mlab-modules/HEATBEDMAG01/hw/cad/step/heater-PCB.stp

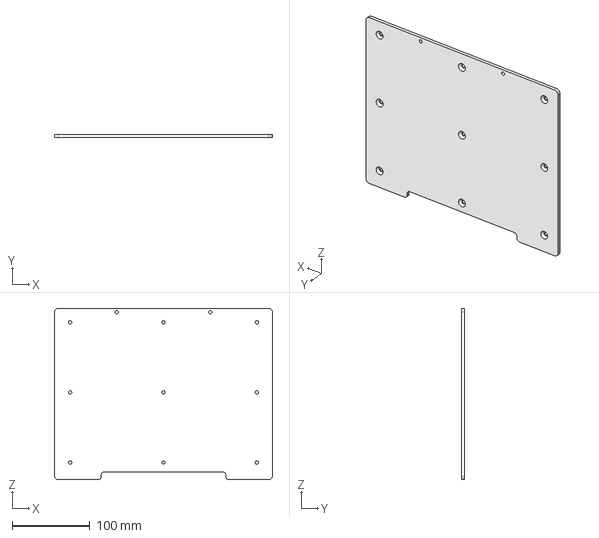
[picture p1: CAD file, 2020-06-01]
hw/cad/step/heater-PCB.stp
280.0 x 4.00 x 220.0 mm
