mlab-modules/HEATBEDMAG01/hw/dxf/slots-for-magnets.dxf

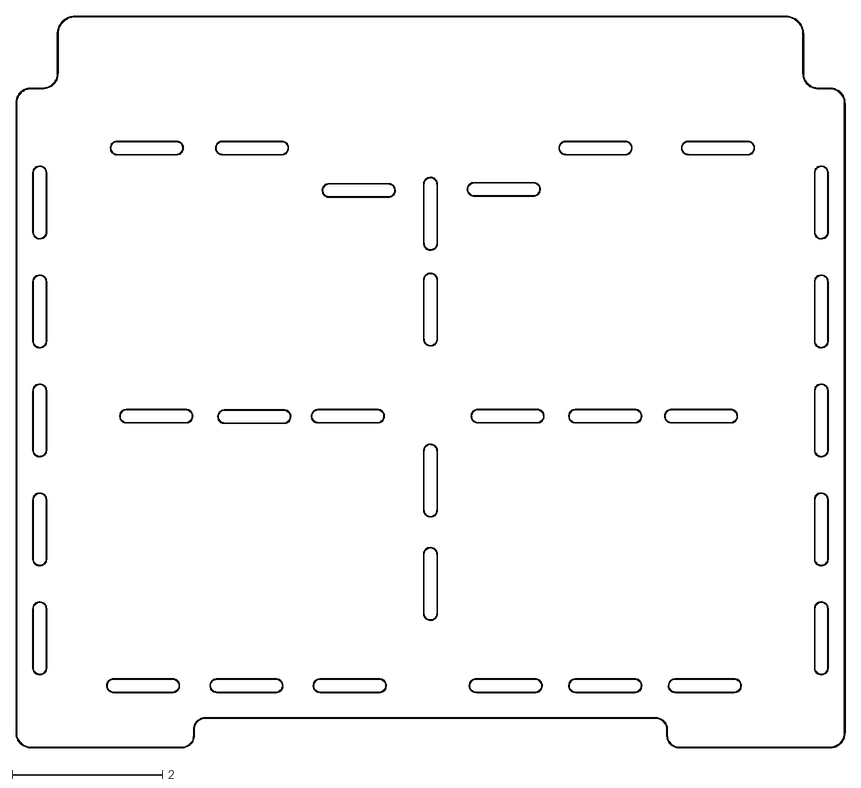
[picture p2: CAD file, 2020-09-24]
hw/dxf/slots-for-magnets.dxf
11.0 x 9.74
