mlab-modules/HEATBEDMAG01/hw/dxf/steel-sheet.dxf

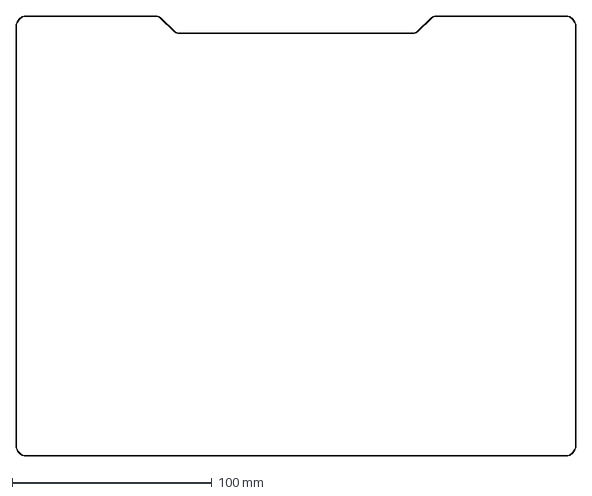
[picture p3: CAD file, 2020-09-18]
hw/dxf/steel-sheet.dxf
280.0 x 220.0 mm
