mlab-modules/HEATBEDMAG01/hw/dxf/heatbed_table.dxf

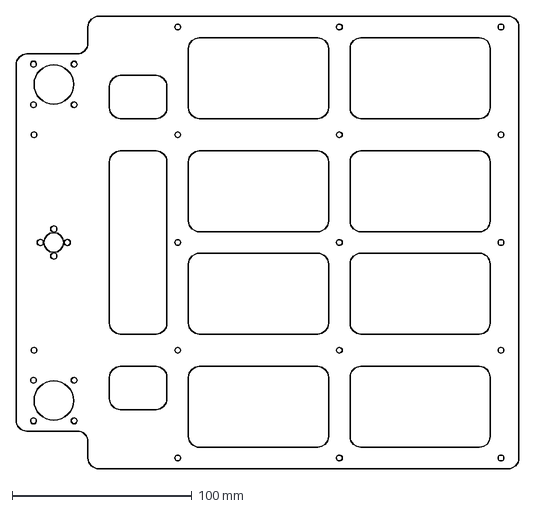
[picture p4: CAD file, 2020-09-13]
hw/dxf/heatbed_table.dxf
280.0 x 252.0 mm
