mlab-modules/HEATBEDMAG01/hw/dxf/Heatbed.dxf

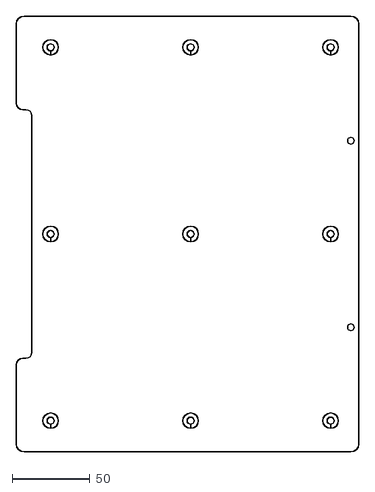
[picture p5: CAD file, 2020-06-01]
hw/dxf/Heatbed.dxf
220.0 x 280.0
