mlab-modules/HEATBEDMAG01/hw/sch_pcb/Heatbed.pdf

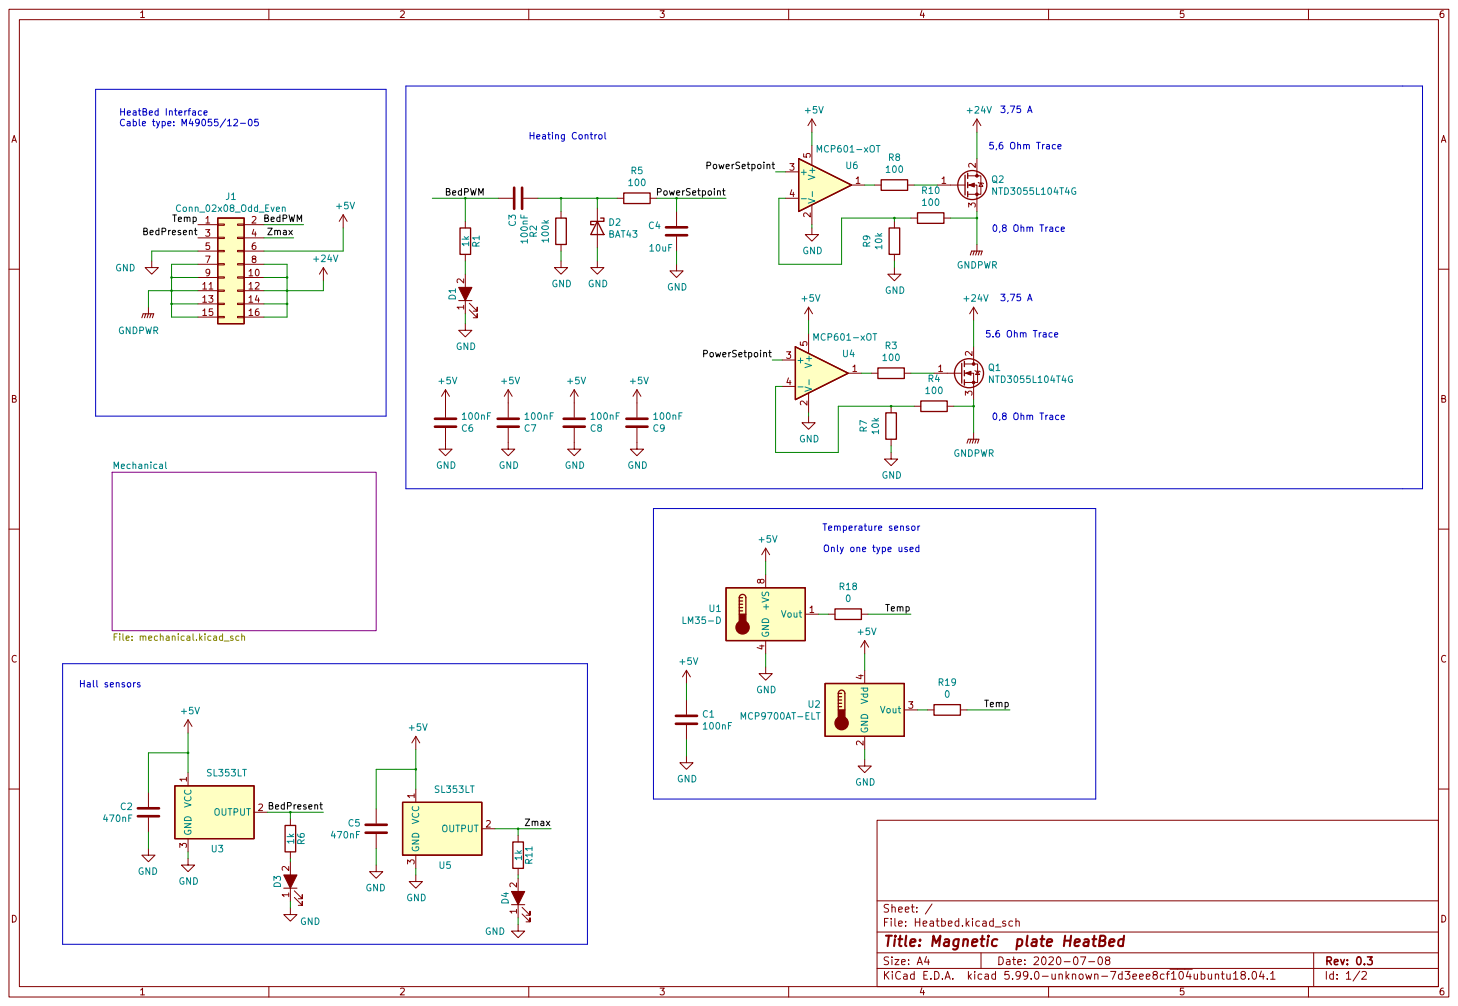
[picture p6: page 1]

0,8 Ohm Trace HeatBed Interface Cable type: M49055/12-05

9 | | 10
11 | | 12
13 | | 14
15 | | 16

Only one type used

Id: 1/2 Title: Magnetic plate HeatBed

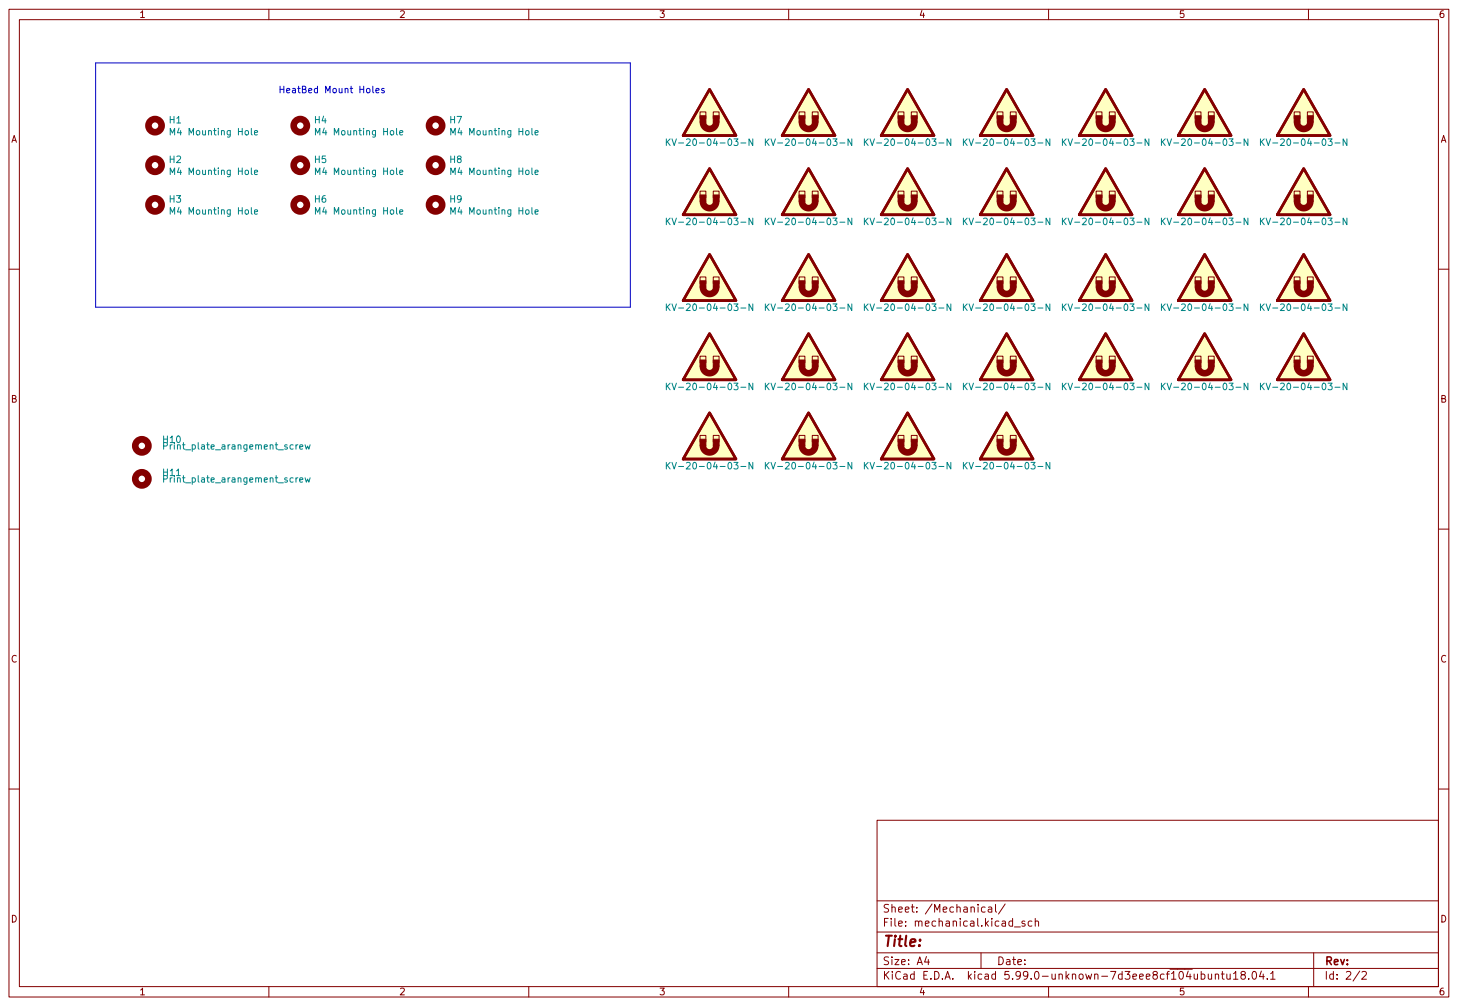
[picture p7: page 2]

File: mechanical.kicad_sch Sheet: /Mechanical/
Id: 2/2 Title:
