mlab-modules/HEATBEDMAG01/(commit log)

2020-06-01 New step model of heating PCB.
    [heater-PCB.stp]
2020-06-01 Cleanup of project files.
    [slots-for-magnets-05.dxf, steel-sheet.dxf]
2020-06-01 Cleanup old 12V version.
    [Heatbed-MK52.kicad_pcb, Heatbed-MK52.sch]
2020-06-01 Renaming the project.
    [Heatbed.kicad_pcb, Heatbed.sch]
2020-06-01 Imported new DXF outline.
    [Heatbed.dxf, Heatbed.kicad_pcb, Heatbed.kicad_sch]
2020-07-08 Save the cable connection pinout.
    [Heatbed.kicad_sch, Heatbed.sch, cable_signal_allocation.ods]
2020-07-08 New heatbed schematics.
    [Heatbed.kicad_sch, cable_signal_allocation.ods]
2020-07-08 Add current control circuit.
    [Heatbed.kicad_sch]
2020-09-09 Adding the hall effect sensors.
    [Heatbed.kicad_pcb, Heatbed.kicad_sch]
2020-09-09 Add datasheet to hall-effect sensor.
2020-09-10 Complete schematics starting PCB work.
2020-09-10 The first full routed idea.
    [Heatbed.kicad_pcb]
2020-09-10 Magnet pocket layout.
    [Heatbed.kicad_pcb]
2020-09-10 Magnet outline grouping trouble.
    [Heatbed.kicad_pcb]
2020-09-11 The first slots for magnets.
    [Heatbed.kicad_pcb]
2020-09-11 Mounting holes.
    [Heatbed.kicad_sch]
2020-09-11 New schamatics sheet with mechanical symbols.
    [mechanical.kicad_sch]
2020-09-11 Exchange board outline holes with mounting holes symbols.
    [Heatbed.kicad_pcb, Heatbed.kicad_sch]
2020-09-11 Add print plate arangement screws.
    [Heatbed.kicad_sch, mechanical.kicad_sch]
2020-09-11 Magnets handled as PCB components.
    [Heatbed.kicad_pcb, Heatbed.kicad_sch, mechanical.kicad_sch]
2020-09-12 Magnets aligment.
    [Heatbed.kicad_pcb]
2020-09-13 copper pour cleanup.
    [Heatbed.kicad_pcb]
2020-09-13 Add heatbed table layout.
    [heatbed_table.dxf]
2020-09-13 The first resistive meanders.
    [Heatbed.kicad_pcb]
2020-09-13 Experiments with meandering.
    [Heatbed.kicad_pcb]
2020-09-14 Simplified to two zone variant.
    [Heatbed.kicad_pcb, Heatbed.kicad_sch]
2020-09-17 Routing tests.
    [Heatbed.kicad_pcb, Heatbed.kicad_sch]
2020-09-18 PCB routing.
    [Heatbed.kicad_pcb, steel-sheet.dxf]
2020-09-18 Avoiding to screws.
    [Heatbed.kicad_pcb]
2020-09-21 Zones edits and routing.
    [Heatbed.kicad_pcb, Heatbed.kicad_sch, mechanical.kicad_sch]
2020-09-22 Zone infill improvement.
    [Heatbed.kicad_pcb, Heatbed.kicad_sch, mechanical.kicad_sch]
2020-09-23 routing optimalization zone infills.
    [Heatbed.kicad_pcb]
2020-09-24 Routing and zones cleanup.
    [Heatbed.kicad_pcb, Heatbed.kicad_sch, slots-for-magnets.dxf]
2020-09-24 Fix via annulus.
    [Heatbed.kicad_pcb, slots-for-magnets.dxf]
2020-09-30 New magnet outline in footprint.
    [Heatbed.kicad_pcb]
2020-09-30 silkscreen cleanup.
    [Heatbed.kicad_pcb]
